philipposklad/iot-alarm-system/hardware/images/breadboard-keypad.jpg

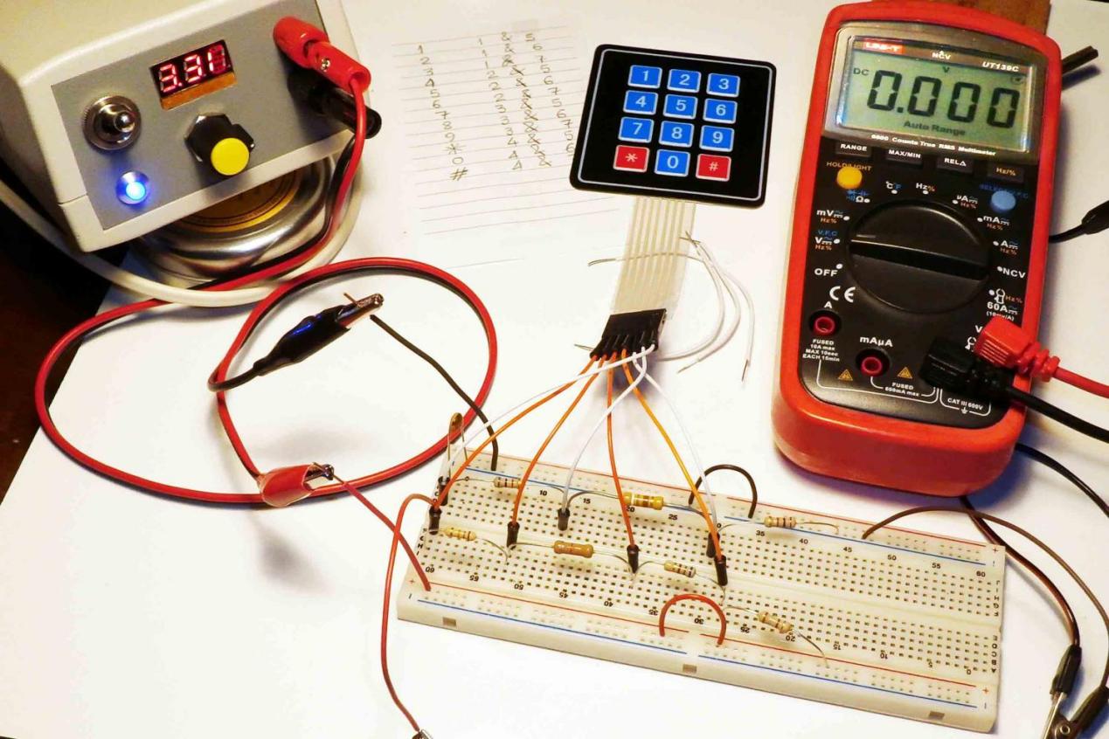
hardware/images/breadboard-keypad.jpg
