philipposklad/iot-alarm-system/hardware/images/prototype-internal-keypad-LM317-optocouplers.jpg

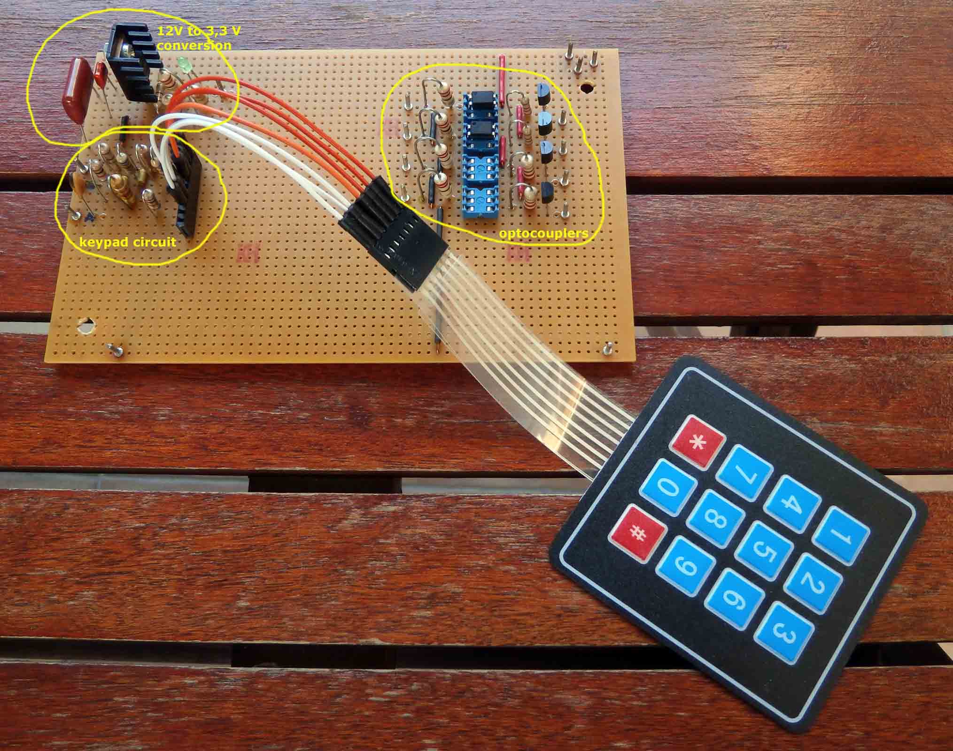
hardware/images/prototype-internal-keypad-LM317-optocouplers.jpg
