philipposklad/iot-alarm-system/images/alarm-state-machine.png

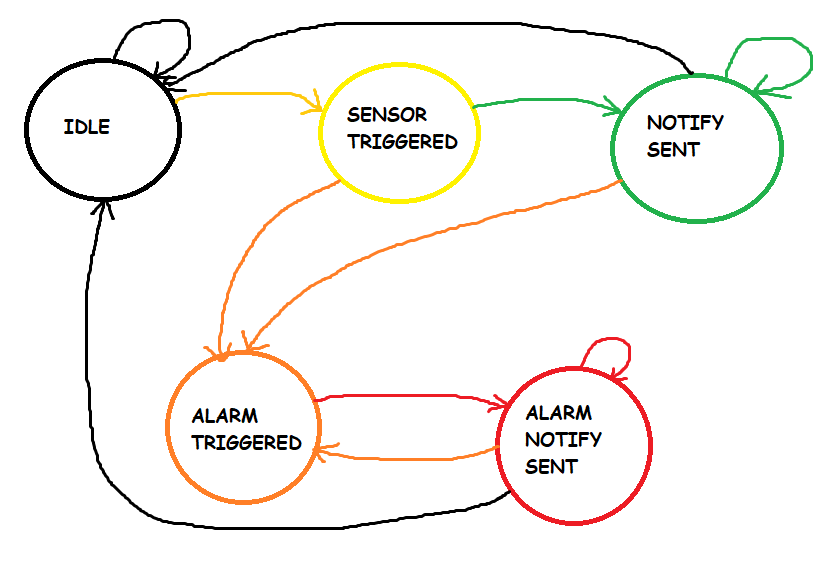
images/alarm-state-machine.png
