philipposklad/iot-alarm-system/images/IoT-Remote-Dashboards-Menu.jpg

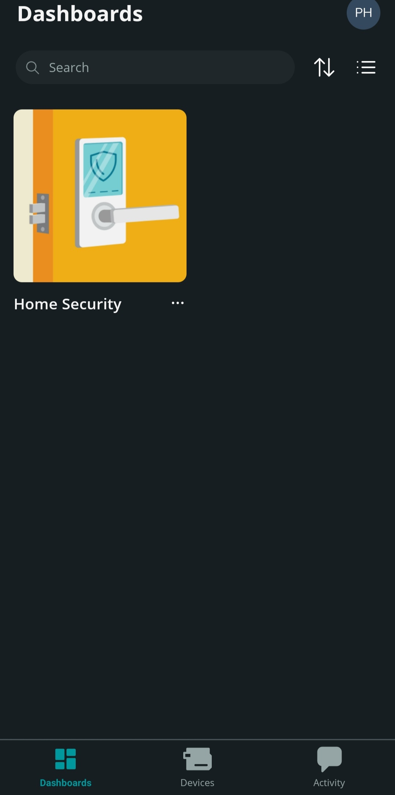
images/IoT-Remote-Dashboards-Menu.jpg
