philipposklad/iot-alarm-system/images/IoT-Remote-Devices.jpg

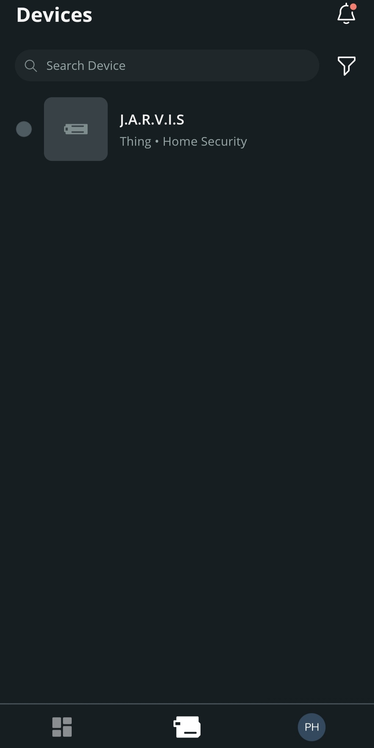
images/IoT-Remote-Devices.jpg
