philipposklad/iot-alarm-system/(commit log)

2026-07-29 Added full firmware code
    Added all the finished firmware code to the project. Also changed .gitignore to avoid pushing .theia folder
    [iot-alarm-system.ino, keypad.cpp, keypad.h, microcontroller.cpp, microcontroller.h, sensor.cpp, sensor.h, siren.cpp]
2026-08-14 Created bom.md
    Created bom.md in hardware. Links from README.md should work now.
2026-08-14 Added pictures and schematics
    Added pictures and schematics as well as references in README.md
2026-08-14 Added images
    2 internal images of prototype and breadboard
2026-08-14 Added 2 to schematics
    LM317 voltage regulator and keypad circuit
2026-08-14 Corrected name
    Corrected reference to LM317-voltage-regulator-circuit.png
